benkrasnow/1v2-boost-converter/README.md

# 1v2-boost-converter
Schematics and PCB layout for a boost converter 0.9V minimum input, 30A maximum input current
