benkrasnow/1v2-boost-converter/1v2boost/1v2boost.kicad_pcb

## KiCad design 1v2boost/1v2boost.kicad_pcb (2026-09-29)

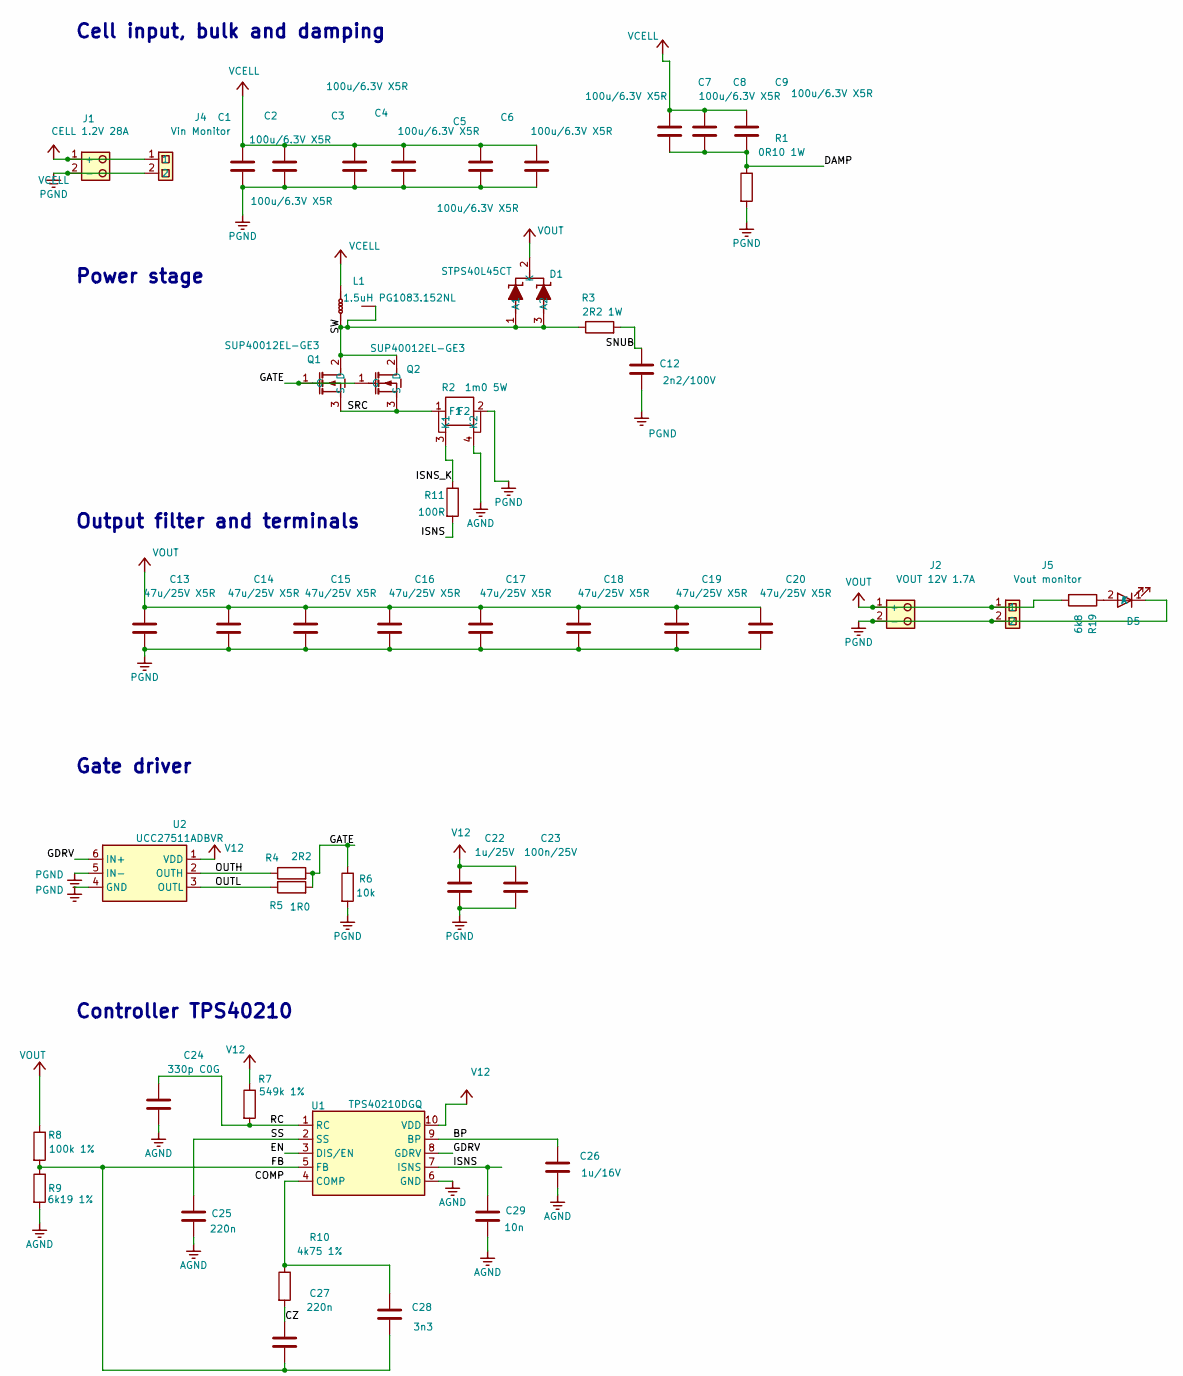
[picture p1: schematic 1v2boost.kicad_sch, 1.2 V to 12 V / 20 W Boost Converter, part in row 1, column 1]

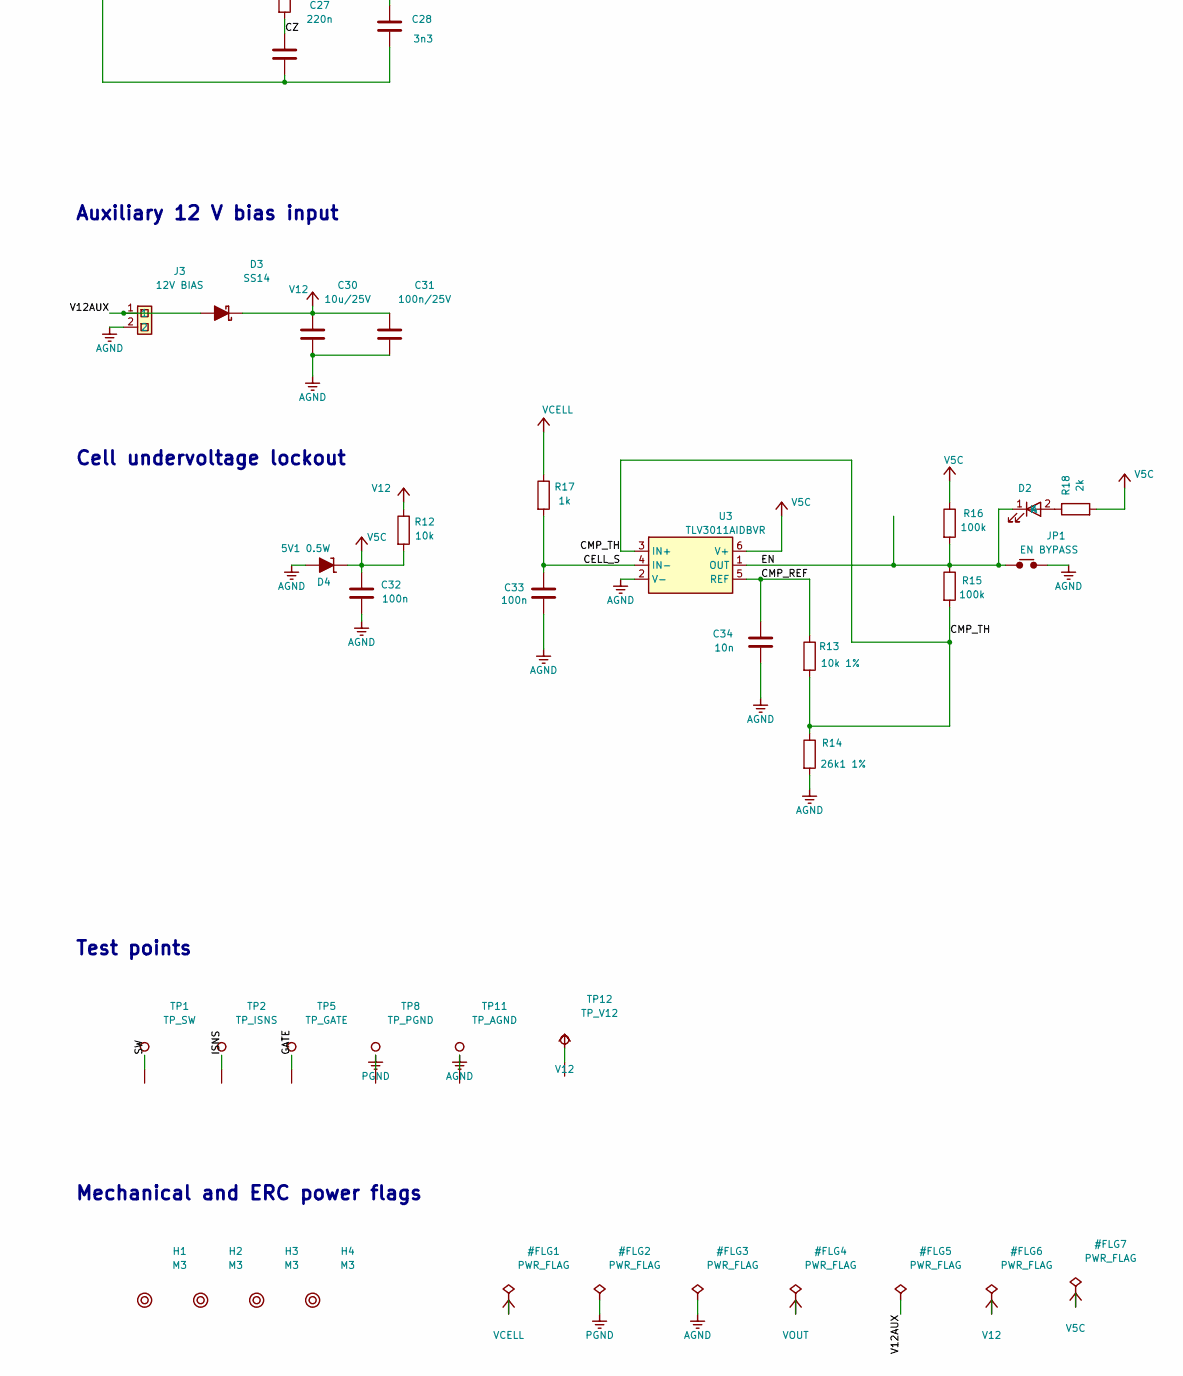
[picture p2: schematic 1v2boost.kicad_sch, 1.2 V to 12 V / 20 W Boost Converter, part in row 2, column 1]

Parts:
C1, C2, C3, C4, C5, C6, C7, C8, C9: 100u/6.3V X5R; C_1210_3225Metric; MPN CL32A107MQVNNWE; Digi-Key P/N 1276-3366-1-ND
C12: 2n2/100V; C_1210_3225Metric; MPN C1210C222J1GACTU; Digi-Key P/N 399-C1210C222J1GACTUCT-ND
C13, C14, C15, C16, C17, C18, C19, C20: 47u/25V X5R; C_1210_3225Metric; MPN TMK325ABJ476MM-P; Digi-Key P/N 587-5479-1-ND
C22: 1u/25V; C_0805_2012Metric; MPN C0805C105K3RACTU; Digi-Key P/N 399-C0805C105K3RACTUCT-ND
C23, C31: 100n/25V; C_0603_1608Metric; MPN C0603C104K5RACTU; Digi-Key P/N 399-C0603C104K5RACTUCT-ND
C24: 330p C0G; C_0603_1608Metric; MPN CL10C331JB8NNNC; Digi-Key P/N 1276-1073-1-ND
C25, C27: 220n; C_0603_1608Metric; MPN GRM188R71H224KAC4D; Digi-Key P/N 490-12546-1-ND
C26: 1u/16V; C_0603_1608Metric; MPN C0603C105K4RACTU; Digi-Key P/N 399-C0603C105K4RACTUCT-ND
C28: 3n3; C_0603_1608Metric; MPN GCM1885C1H332FA16D; Digi-Key P/N 490-GCM1885C1H332FA16DCT-ND
C29: 10n; C_0603_1608Metric
C30: 10u/25V; C_1210_3225Metric; MPN C3225X7R1E106M250AC; Digi-Key P/N 445-1434-1-ND
C32, C33: 100n; C_0603_1608Metric; MPN C0603C104K5RACTU; Digi-Key P/N 399-C0603C104K5RACTUCT-ND
C34: 10n; C_0603_1608Metric; MPN CL10B103KB8NNNC; Digi-Key P/N 1276-1009-1-ND
D1: STPS40L45CT; TO-220-3_Vertical; MPN STPS40L45CT; Digi-Key P/N 497-7567-5-ND
D2, D5: LED_0603
D3: SS14; D_SMA; MPN SS14; Digi-Key P/N SS14CT-ND
D4: 5V1 0.5W; D_SOD-123; MPN MMSZ5231B-7-F; Digi-Key P/N MMSZ5231B-FDICT-ND
H1, H2, H3, H4: M3; MountingHole_3.2mm_M3
J1: CELL 1.2V 28A; SolderPad_Pair_Input_14x10mm
J2: VOUT 12V 1.7A; SolderPad_Pair_Output_8x6mm
J3: 12V BIAS; PinHeader_1x02_P2.54mm; MPN PREC002SAAN-RC; Digi-Key P/N 35-PREC002SAAN-RC-ND
J4: Vin Monitor; PinHeader_1x02_P2.54mm; MPN PREC002SAAN-RC; Digi-Key P/N 35-PREC002SAAN-RC-ND
J5: Vout monitor; PinHeader_1x02_P2.54mm; MPN PREC002SAAN-RC; Digi-Key P/N 35-PREC002SAAN-RC-ND
JP1: EN BYPASS; R_0805_2012Metric; MPN RC0805JR-070RL; Digi-Key P/N 311-0.0ARCT-ND
L1: 1.5uH PG1083.152NL; L_Pulse_PG1083; MPN PG1083.152NL; Digi-Key P/N 553-3164-ND
Q1, Q2: SUP40012EL-GE3; TO-220-3_Vertical; MPN SUP40012EL-GE3; Digi-Key P/N SUP40012EL-GE3-ND
R1: 0R10 1W; R_1210_3225Metric; MPN RCWE1210R100FKEA; Digi-Key P/N 541-4390-1-ND
R2: 1m0 5W; R_Shunt_2512_CSS2H; MPN CSS2H-2512R-1L00F; Digi-Key P/N CSS2H-2512R-1L00FCT-ND
R3: 2R2 1W; R_1210_3225Metric; MPN ESR25JZPJ2R2; Digi-Key P/N RHM2.2AXCT-ND
R4: 2R2; R_0805_2012Metric; MPN RC0805FR-072R2L; Digi-Key P/N 311-2.20CRCT-ND
R5: 1R0; R_0805_2012Metric; MPN RC0805FR-071RL; Digi-Key P/N 311-1.00CRCT-ND
R6: 10k; R_0805_2012Metric; MPN RC0805FR-0710KL; Digi-Key P/N 311-10.0KCRCT-ND
R7: 549k 1%; R_0603_1608Metric; MPN RC0603FR-07549KL; Digi-Key P/N 311-549KHRCT-ND
R8: 100k 1%; R_0603_1608Metric; MPN RC0603FR-07100KL; Digi-Key P/N 311-100KHRCT-ND
R9: 6k19 1%; R_0603_1608Metric; MPN ERJ-3EKF6191V; Digi-Key P/N P6.19KHCT-ND
R10: 4k75 1%; R_0603_1608Metric; MPN RC0603FR-074K75L; Digi-Key P/N 311-4.75KHRCT-ND
R11: 100R; R_0603_1608Metric; MPN RC0603FR-07100RL; Digi-Key P/N 311-100HRCT-ND
R12: 10k; R_0603_1608Metric; MPN RC0603FR-0710KL; Digi-Key P/N 311-10.0KHRCT-ND
R13: 10k 1%; R_0603_1608Metric; MPN RC0603FR-0710KL; Digi-Key P/N 311-10.0KHRCT-ND
R14: 26k1 1%; R_0603_1608Metric; MPN RC0603FR-0726K1L; Digi-Key P/N 311-26.1KHRCT-ND
R15, R16: 100k; R_0603_1608Metric; MPN RC0603FR-07100KL; Digi-Key P/N 311-100KHRCT-ND
R17: 1k; R_0603_1608Metric; MPN RC0603FR-071KL; Digi-Key P/N 311-1.00KHRCT-ND
R18: 2k; R_0603_1608Metric; MPN RC0603FR-07100KL; Digi-Key P/N 311-100KHRCT-ND
R19: 6k8; R_0603_1608Metric; MPN RC0603FR-07100KL; Digi-Key P/N 311-100KHRCT-ND
TP1: TP_SW; TestPoint_Pad_D1.5mm
TP2: TP_ISNS; TestPoint_Pad_D1.5mm
TP5: TP_GATE; TestPoint_Pad_D1.5mm
TP8: TP_PGND; TestPoint_Pad_D1.5mm
TP11: TP_AGND; TestPoint_Pad_D1.5mm
TP12: TP_V12; TestPoint_Pad_D1.5mm
U1: TPS40210DGQ; MSOP-10_3x3mm_P0.5mm; MPN TPS40210DGQR; Digi-Key P/N 296-26969-1-ND
U2: UCC27511ADBVR; SOT-23-6; MPN UCC27511ADBVR; Digi-Key P/N 296-49474-1-ND
U3: TLV3011AIDBVR; SOT-23-6; MPN TLV3011AIDBVR; Digi-Key P/N 296-39259-1-ND

Connections:
/BP: C26.1, U1.9 (BP)
/CELL_S: C33.1, R17.2, U3.4 (IN-)
/CMP_REF: C34.1, R13.1, U3.5 (REF)
/CMP_TH: R13.2, R14.1, R15.2, U3.3 (IN+)
/COMP: C28.1, R10.1, U1.4 (COMP)
/CZ: C27.1, R10.2
/DAMP: C7.2, C8.2, C9.2, R1.1
/EN: D2.1 (K), JP1.1, R15.1, R16.2, U1.3 (DIS/EN), U3.1 (OUT)
/FB: C27.2, C28.2, R8.2, R9.1, U1.5 (FB)
/GATE: Q1.1 (G), Q2.1 (G), R4.2, R5.2, R6.1, TP5.1 (1_1)
/GDRV: U1.8 (GDRV), U2.6 (IN+)
/ISNS: C29.1, R11.2, TP2.1 (1_1), U1.7 (ISNS)
/ISNS_K: R2.3 (K1), R11.1
/OUTH: R4.1, U2.2 (OUTH)
/OUTL: R5.1, U2.3 (OUTL)
/RC: C24.1, R7.2, U1.1 (RC)
/SNUB: C12.1, R3.2
/SRC: Q1.3 (S), Q2.3 (S), R2.1 (F1)
/SS: C25.1, U1.2 (SS)
/SW: D1.1 (A1), D1.3 (A2), L1.2, L1.3 (Mech_3), Q1.2 (D), Q2.2 (D), R3.1, TP1.1 (1_1)
/V12AUX: D3.2 (A), J3.1
AGND: C24.2, C25.2, C26.2, C29.2, C30.2, C31.2, C32.2, C33.2, C34.2, D4.2 (A), J3.2, JP1.2, R2.4 (K2), R9.2, R14.2, TP11.1 (1_1), U1.6 (GND), U3.2 (V-)
unnamed: D2.2 (A), R18.1
unnamed: D5.2 (A), R19.1
PGND: C1.2, C2.2, C3.2, C4.2, C5.2, C6.2, C12.2, C13.2, C14.2, C15.2, C16.2, C17.2, C18.2, C19.2, C20.2, C22.2, C23.2, D5.1 (K), J1.2 (-), J2.2 (-), J4.2, J5.2, R1.2, R2.2 (F2), R6.2, TP8.1 (1_1), U2.4 (GND), U2.5 (IN-)
V5C: C32.1, D4.1 (K), R12.2, R16.1, R18.2, U3.6 (V+)
V12: C22.1, C23.1, C30.1, C31.1, D3.1 (K), R7.1, R12.1, TP12.1 (1_1), U1.10 (VDD), U2.1 (VDD)
VCELL: C1.1, C2.1, C3.1, C4.1, C5.1, C6.1, C7.1, C8.1, C9.1, J1.1 (+), J4.1, L1.1, R17.1
VOUT: C13.1, C14.1, C15.1, C16.1, C17.1, C18.1, C19.1, C20.1, D1.2 (K), J2.1 (+), J5.1, R8.1, R19.2

Notes on the sheet:
Cell input, bulk and damping
Auxiliary 12 V bias input
Controller TPS40210
Gate driver
Power stage
Cell undervoltage lockout
Test points
Output filter and terminals
Mechanical and ERC power flags

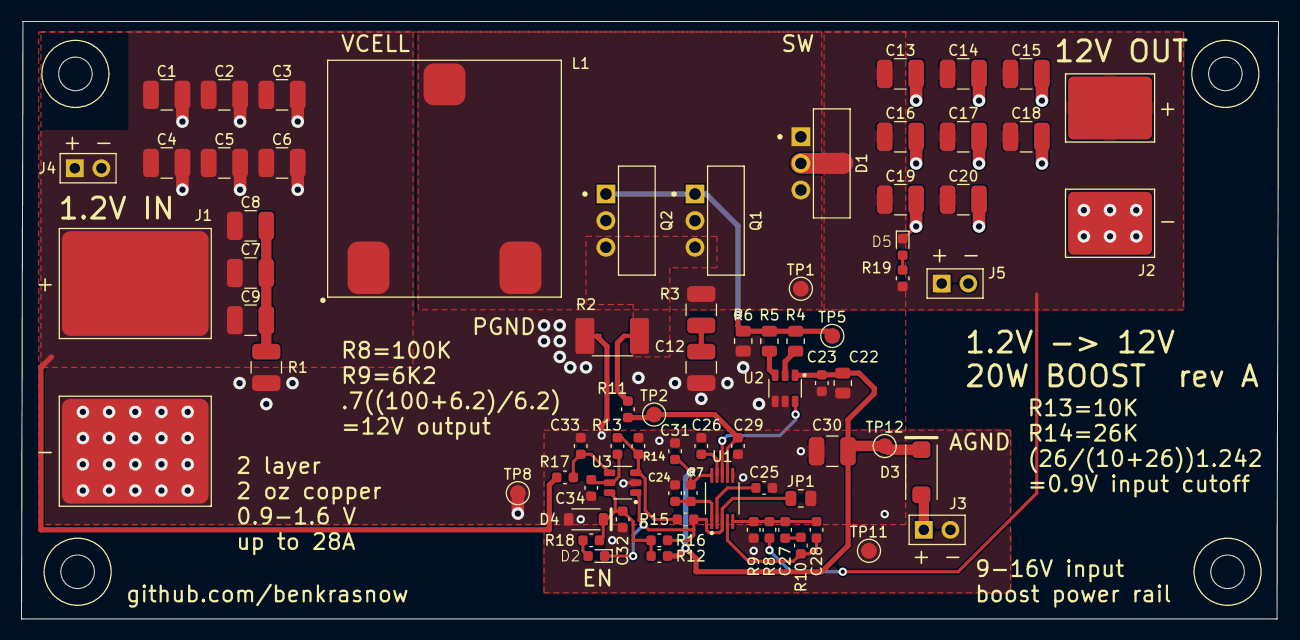
[picture p3: board 1v2boost.kicad_pcb from above]

Board: 2 copper layers, 119.9 x 57.0 mm, 77 parts (0 on the bottom side), 29 nets.
